MuonPi/low-power-gsm-gprs-board/(commit log)

2021-06-01 Added curent kicad files
    [low_power_gsm-gprs.kicad_pcb, low_power_gsm-gprs.sch]
2021-06-01 Fixed up library name
    [low_power_gsm-gprs.sch]
2021-06-01 Updated parts library
    [low_power_gsm-gprs.sch]
2021-06-01 Updated footprints to be correct.
    [low_power_gsm-gprs.kicad_pcb, low_power_gsm-gprs.sch]
2021-06-01 Updated footprint library to latest commit
2021-06-01 Adjusted Footprints
    [low_power_gsm-gprs.kicad_pcb, low_power_gsm-gprs.sch]
2021-06-01 Updated footprint reference
    [low_power_gsm-gprs.kicad_pcb, low_power_gsm-gprs.sch]
2021-06-01 Updated PCB Design
    [low_power_gsm-gprs.kicad_pcb]
2021-06-01 Upated tracks for VCC for ublox chip
    [low_power_gsm-gprs.kicad_pcb]
2021-06-01 Fixed Antenna interface waveguide
    [low_power_gsm-gprs.kicad_pcb]
2021-06-01 Cleaned up silklayer text locations
    [low_power_gsm-gprs.kicad_pcb]
2021-06-01 Updated to newest kicad version
    [low_power_gsm-gprs.kicad_pcb, low_power_gsm-gprs.kicad_sch, low_power_gsm-gprs.sch]
2021-06-01 Migrated to new kicad version
    [low_power_gsm-gprs.kicad_pcb]
2021-06-01 Using newest footprint library
2021-06-01 Updated board power supply
    [low_power_gsm-gprs.kicad_pcb, low_power_gsm-gprs.kicad_sch]
2021-06-01 Updated PCB
    [low_power_gsm-gprs.kicad_pcb]
2021-06-08 Updated design rules to comply with jlcpcb
    [low_power_gsm-gprs.kicad_pcb]
2021-06-08 Moved trace from internal layer to outer layer
    [low_power_gsm-gprs.kicad_pcb]
